nsty/ChrisBox/PCB/ChrisPCB.kicad_pcb

## KiCad design PCB/ChrisPCB.kicad_pcb (2026-08-30)

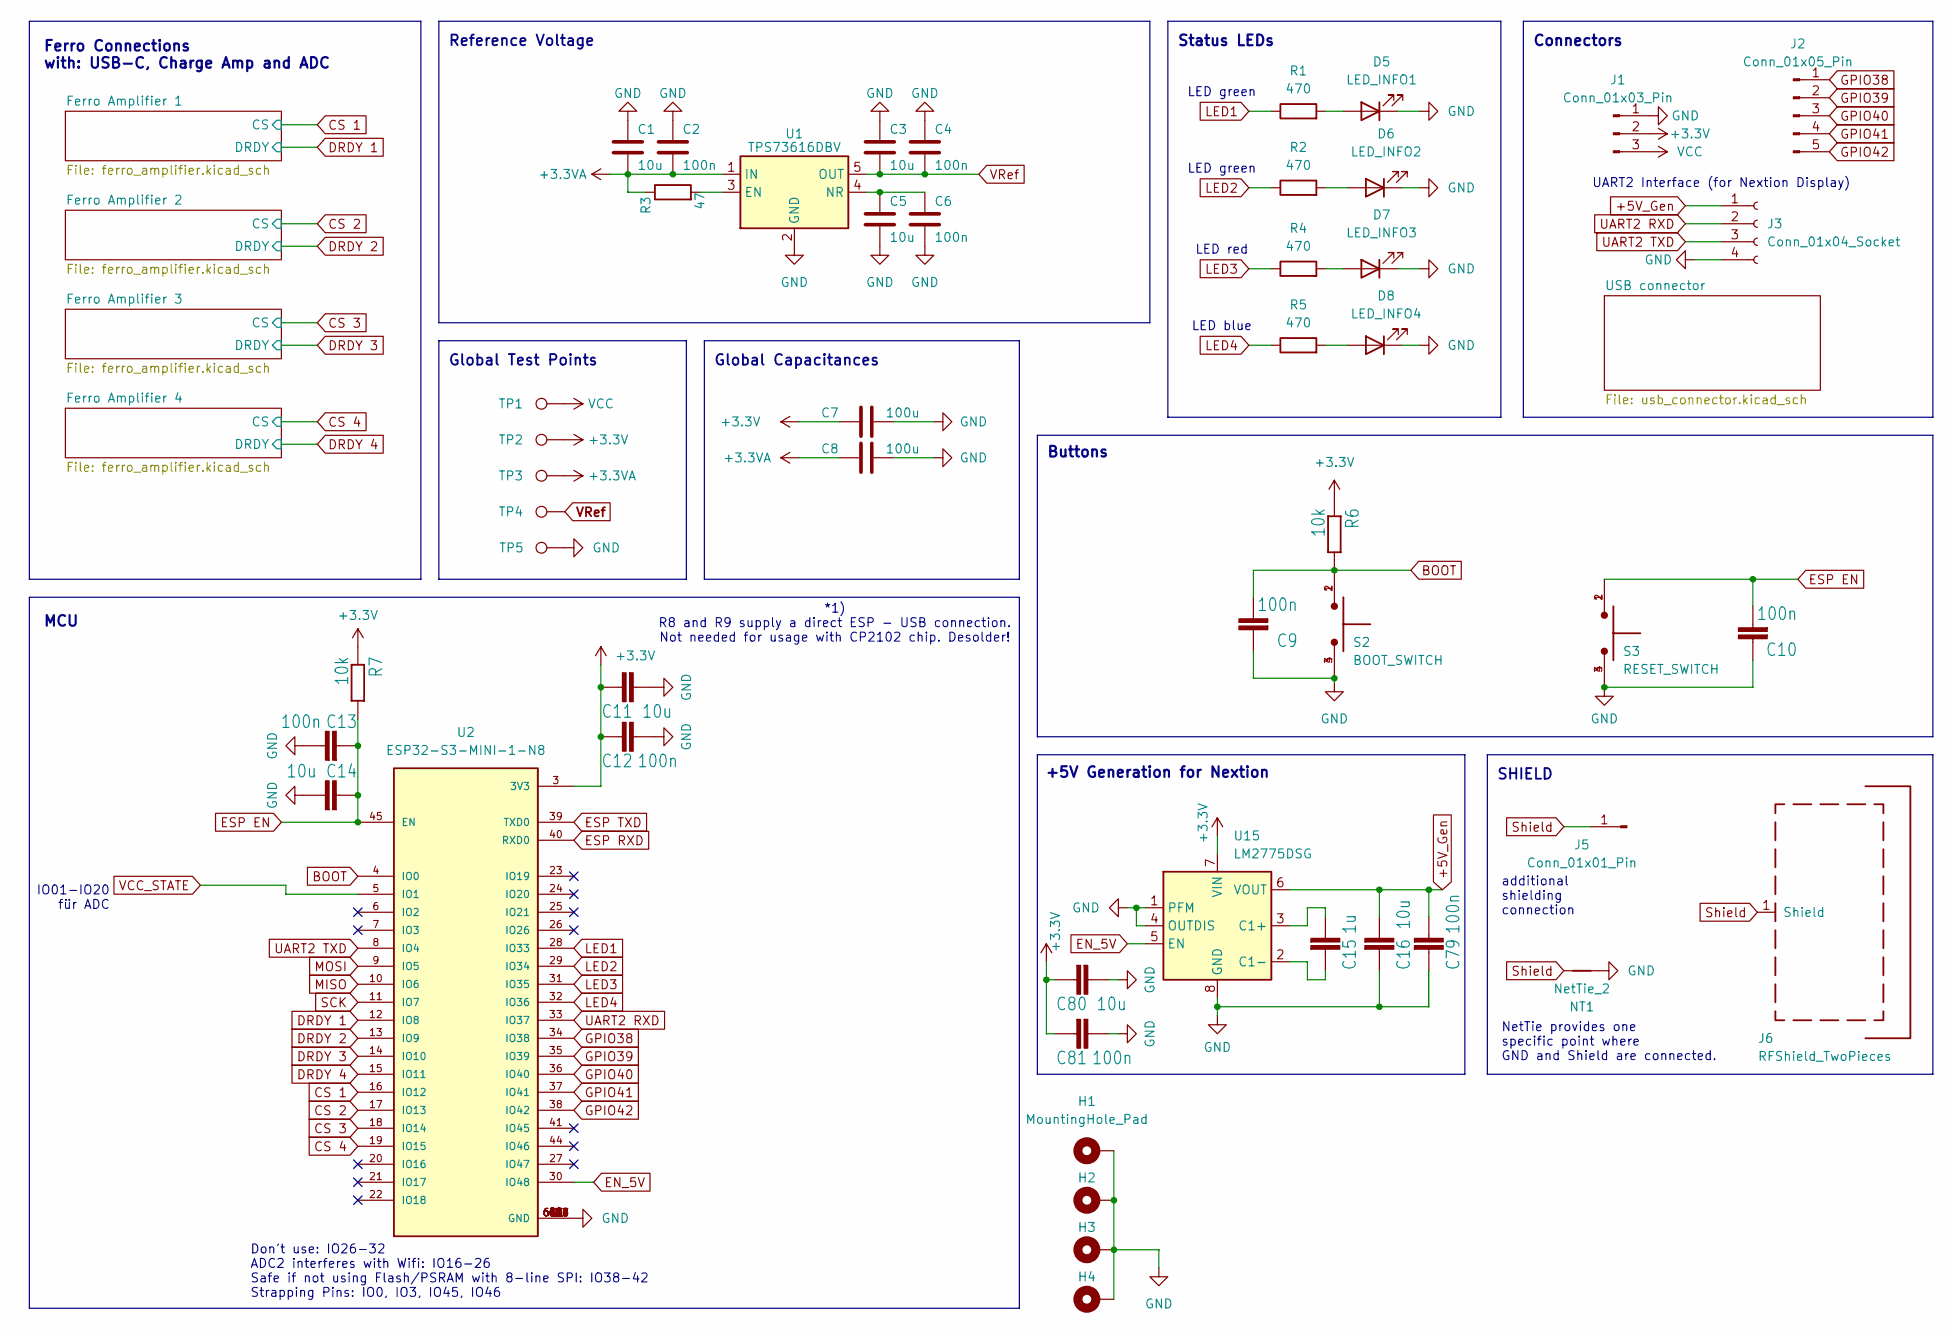
[picture p1: schematic ChrisPCB.kicad_sch, 4-Kanal Ferroelektret Platine]

Parts:
C1, C3, C5, C11, C14, C16, C80: 10u; C_0402_1005Metric
C2, C4, C6, C9, C10, C12, C13, C79, C81: 100n; C_0402_1005Metric
C7, C8: 100u; C_1206_3216Metric
C15: 1u; C_0402_1005Metric
D5: LED_INFO1; LED_0402_1005Metric
D6: LED_INFO2; LED_0402_1005Metric
D7: LED_INFO3; LED_0402_1005Metric
D8: LED_INFO4; LED_0402_1005Metric
H1, H2, H3, H4: MountingHole_Pad; MountingHole_3.2mm_M3_Pad
J1: Conn_01x03_Pin; PinHeader_1x03_P2.54mm_Vertical
J2: Conn_01x05_Pin; PinHeader_1x05_P2.54mm_Vertical
J3: Conn_01x04_Socket; JST_XH_B4B-XH-A_1x04_P2.50mm_Vertical
J5: Conn_01x01_Pin; PinHeader_1x01_P2.54mm_Vertical
J6: RFShield_TwoPieces; Laird_Technologies_BMI-S-205-F_38.10x25.40mm_HandSolder_Sel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
NT1: NetTie_2; NetTie-2_SMD_Pad0.5mm
R1, R2, R4, R5: 470; R_0402_1005Metric
R3: 47; R_0402_1005Metric
R6, R7: 10k; R_0402_1005Metric
S2: BOOT_SWITCH; SW_SKRPABE010
S3: RESET_SWITCH; SW_SKRPABE010
TP1, TP2, TP3, TP4, TP5: TestPoint; TestPoint_THTPad_D1.5mm_Drill0.7mm
U1: TPS73616DBV; SOT-23-5
U2: ESP32-S3-MINI-1-N8; XCVR_ESP32-S3-MINI-1-N8; PARTREV v0.6
U15: LM2775DSG; WSON-8-1EP_2x2mm_P0.5mm_EP0.9x1.6mm_ThermalVias

Connections:
+3.3V: C7.1, C11.2, C12.2, C80.2, C81.2, J1.2, R6.1, R7.1, TP2.1, U2.3 (3V3), U15.7 (VIN); also elsewhere on the board
+3.3VA: C1.2, C2.2, C8.1, R3.1, TP3.1, U1.1 (IN); also elsewhere on the board
+5V_Gen: C16.1, C79.1, J3.1, U15.6 (VOUT)
BOOT: C9.2, R6.2, S2.1, S2.2, U2.4 (IO0); also elsewhere on the board
CS 1: U2.16 (IO12); also elsewhere on the board
CS 2: U2.17 (IO13); also elsewhere on the board
CS 3: U2.18 (IO14); also elsewhere on the board
CS 4: U2.19 (IO15); also elsewhere on the board
DRDY 1: U2.12 (IO8); also elsewhere on the board
DRDY 2: U2.13 (IO9); also elsewhere on the board
DRDY 3: U2.14 (IO10); also elsewhere on the board
DRDY 4: U2.15 (IO11); also elsewhere on the board
EN_5V: U2.30 (IO48), U15.5 (EN)
ESP EN: C10.2, C13.2, C14.2, R7.2, S3.1, S3.2, U2.45 (EN); also elsewhere on the board
ESP RXD: U2.40 (RXD0); also elsewhere on the board
ESP TXD: U2.39 (TXD0); also elsewhere on the board
GND: C1.1, C2.1, C3.1, C4.1, C5.2, C6.2, C7.2, C8.2, C9.1, C10.1, C11.1, C12.1, C13.1, C14.1, C16.2, C79.2, C80.1, C81.1, D5.1 (K), D6.1 (K), D7.1 (K), D8.1 (K), H1.1, H2.1, H3.1, H4.1, J1.1, J3.4, NT1.1, S2.3, S2.4, S3.3, S3.4, TP5.1, U1.2 (GND), U2.1 (GND), U2.2 (GND), U2.42 (GND), U2.43 (GND), U2.46 (GND), U2.47 (GND), U2.48 (GND), U2.49 (GND), U2.50 (GND), U2.51 (GND), U2.52 (GND), U2.53 (GND), U2.54 (GND), U2.55 (GND), U2.56 (GND), U2.57 (GND), U2.58 (GND), U2.59 (GND), U2.60 (GND), U2.61 (GND), U2.61_1 (GND), U2.61_2 (GND), U2.61_3 (GND), U2.61_4 (GND), U2.61_5 (GND), U2.61_6 (GND), U2.61_7 (GND), U2.61_8 (GND), U2.62 (GND), U2.63 (GND), U2.64 (GND), U2.65 (GND), U15.1 (PFM), U15.4 (OUTDIS), U15.8 (GND), U15.9 (GND); also elsewhere on the board
GPIO38: J2.1, U2.34 (IO38)
GPIO39: J2.2, U2.35 (IO39)
GPIO40: J2.3, U2.36 (IO40)
GPIO41: J2.4, U2.37 (IO41)
GPIO42: J2.5, U2.38 (IO42)
LED1: R1.1, U2.28 (IO33)
LED2: R2.1, U2.29 (IO34)
LED3: R4.1, U2.31 (IO35)
LED4: R5.1, U2.32 (IO36)
MISO: U2.10 (IO6); also elsewhere on the board
MOSI: U2.9 (IO5); also elsewhere on the board
unnamed: D5.2 (A), R1.2
unnamed: D6.2 (A), R2.2
unnamed: D7.2 (A), R4.2
unnamed: D8.2 (A), R5.2
unnamed: R3.2, U1.3 (EN)
unnamed: C5.1, C6.1, U1.4 (NR)
unnamed: C15.1, U15.3 (C1+)
unnamed: C15.2, U15.2 (C1-)
SCK: U2.11 (IO7); also elsewhere on the board
Shield: J5.1, J6.1 (Shield), NT1.2; also elsewhere on the board
UART2 RXD: J3.2, U2.33 (IO37)
UART2 TXD: J3.3, U2.8 (IO4)
VCC: J1.3, TP1.1; also elsewhere on the board
VCC_STATE: U2.5 (IO1); also elsewhere on the board
VRef: C3.2, C4.2, TP4.1, U1.5 (OUT); also elsewhere on the board

Notes on the sheet:
+5V Generation for Nextion
Global Capacitances
Global Test Points
Buttons
LED green
Reference Voltage
Ferro Connections with: USB-C, Charge Amp and ADC
NetTie provides one specific point where GND and Shield are connected.
Status LEDs
IO01-IO20 für ADC
MCU
SHIELD
Don't use: IO26-32 ADC2 interferes with Wifi: IO16-26 Safe if not using Flash/PSRAM with 8-line SPI: IO38-42 Strapping Pins: IO0, IO3, IO45, IO46
additional shielding connection
LED blue
*1) R8 and R9 supply a direct ESP - USB connection. Not needed for usage with CP2102 chip. Desolder!
Connectors
LED red
UART2 Interface (for Nextion Display)

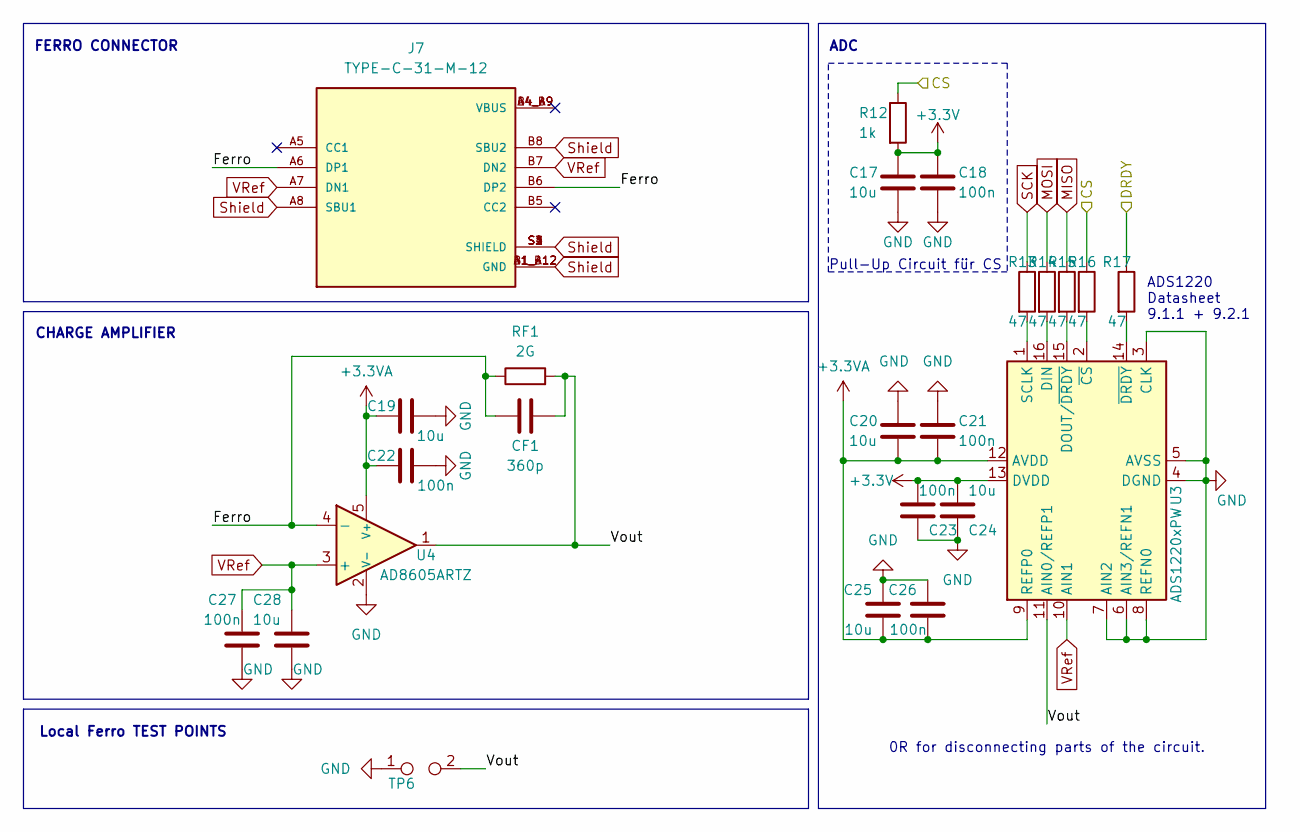
[picture p2: schematic ferro_amplifier.kicad_sch]

Parts:
C17, C19, C20, C24, C25, C28: 10u; C_0402_1005Metric
C18, C21, C22, C23, C26, C27: 100n; C_0402_1005Metric
CF1: 360p; C_0805_2012Metric
J7: TYPE-C-31-M-12; HRO_TYPE-C-31-M-12; PARTREV 2020.12.08
R12: 1k; R_0402_1005Metric
R13, R14, R15, R16, R17: 47; R_0402_1005Metric
RF1: 2G; R_0805_2012Metric
TP6: TestPoint_2Pole; TestPoint_2Pads_Pitch2.54mm_Drill0.8mm
U3: ADS1220xPW; TSSOP-16_4.4x5mm_P0.65mm
U4: AD8605ARTZ; SOT-23-5

Connections:
+3.3V: C17.1, C18.2, C23.2, C24.1, R12.2, U3.13 (DVDD); also elsewhere on the board
+3.3VA: C19.2, C20.2, C21.1, C22.1, C25.1, C26.2, U3.9 (REFP0), U3.12 (AVDD), U4.5 (V+); also elsewhere on the board
/Ferro Amplifier 1/Ferro: CF1.1, J7.A6 (DP1), J7.B6 (DP2), RF1.1, U4.4 (-)
/Ferro Amplifier 1/Vout: CF1.2, RF1.2, TP6.2, U3.11 (AIN0/REFP1), U4.1
CS 1: R12.1, R16.1; also elsewhere on the board
DRDY 1: R17.1; also elsewhere on the board
GND: C17.2, C18.1, C19.1, C20.1, C21.2, C22.2, C23.1, C24.2, C25.2, C26.1, C27.1, C28.2, TP6.1, U3.3 (CLK), U3.4 (DGND), U3.5 (AVSS), U3.6 (AIN3/REFN1), U3.7 (AIN2), U3.8 (REFN0), U4.2 (V-); also elsewhere on the board
MISO: R15.1; also elsewhere on the board
MOSI: R14.1; also elsewhere on the board
unnamed: R14.2, U3.16 (DIN)
unnamed: R15.2, U3.15 (DOUT/~DRDY)
unnamed: R13.2, U3.1 (SCLK)
unnamed: R16.2, U3.2 (~CS)
unnamed: R17.2, U3.14 (~DRDY)
SCK: R13.1; also elsewhere on the board
Shield: J7.A1_B12 (GND), J7.A8 (SBU1), J7.B1_A12 (GND), J7.B8 (SBU2), J7.S1 (SHIELD), J7.S2 (SHIELD), J7.S3 (SHIELD), J7.S4 (SHIELD); also elsewhere on the board
VRef: C27.2, C28.1, J7.A7 (DN1), J7.B7 (DN2), U3.10 (AIN1), U4.3 (+); also elsewhere on the board

Parts of its further copies:
C29, C31, C32, C36, C37, C40, C41, C43, C44, C48, C49, C52, C53, C55, C56, C60, C61, C64: 10u; C_0402_1005Metric
C30, C33, C34, C35, C38, C39, C42, C45, C46, C47, C50, C51, C54, C57, C58, C59, C62, C63: 100n; C_0402_1005Metric
CF2, CF3, CF4: 360p; C_0805_2012Metric
J8, J9, J10: TYPE-C-31-M-12; HRO_TYPE-C-31-M-12; PARTREV 2020.12.08
R18, R24, R30: 1k; R_0402_1005Metric
R19, R20, R21, R22, R23, R25, R26, R27, R28, R29, R31, R32, R33, R34, R35: 47; R_0402_1005Metric
RF2, RF3, RF4: 2G; R_0805_2012Metric
TP7, TP8, TP9: TestPoint_2Pole; TestPoint_2Pads_Pitch2.54mm_Drill0.8mm
U5, U7, U9: ADS1220xPW; TSSOP-16_4.4x5mm_P0.65mm
U6, U8, U10: AD8605ARTZ; SOT-23-5

Connections of its further copies:
+3.3V: C29.1, C30.2, C35.2, C36.1, C41.1, C42.2, C47.2, C48.1, C53.1, C54.2, C59.2, C60.1, R18.2, R24.2, R30.2, U5.13 (DVDD), U7.13 (DVDD), U9.13 (DVDD); also elsewhere on the board
+3.3VA: C31.2, C32.2, C33.1, C34.1, C37.1, C38.2, C43.2, C44.2, C45.1, C46.1, C49.1, C50.2, C55.2, C56.2, C57.1, C58.1, C61.1, C62.2, U5.9 (REFP0), U5.12 (AVDD), U6.5 (V+), U7.9 (REFP0), U7.12 (AVDD), U8.5 (V+), U9.9 (REFP0), U9.12 (AVDD), U10.5 (V+); also elsewhere on the board
/Ferro Amplifier 2/Ferro: CF2.1, J8.A6 (DP1), J8.B6 (DP2), RF2.1, U6.4 (-)
/Ferro Amplifier 2/Vout: CF2.2, RF2.2, TP7.2, U5.11 (AIN0/REFP1), U6.1
/Ferro Amplifier 3/Ferro: CF3.1, J9.A6 (DP1), J9.B6 (DP2), RF3.1, U8.4 (-)
/Ferro Amplifier 3/Vout: CF3.2, RF3.2, TP8.2, U7.11 (AIN0/REFP1), U8.1
/Ferro Amplifier 4/Ferro: CF4.1, J10.A6 (DP1), J10.B6 (DP2), RF4.1, U10.4 (-)
/Ferro Amplifier 4/Vout: CF4.2, RF4.2, TP9.2, U9.11 (AIN0/REFP1), U10.1
CS 2: R18.1, R22.1; also elsewhere on the board
CS 3: R24.1, R28.1; also elsewhere on the board
CS 4: R30.1, R34.1; also elsewhere on the board
DRDY 2: R23.1; also elsewhere on the board
DRDY 3: R29.1; also elsewhere on the board
DRDY 4: R35.1; also elsewhere on the board
GND: C29.2, C30.1, C31.1, C32.1, C33.2, C34.2, C35.1, C36.2, C37.2, C38.1, C39.1, C40.2, C41.2, C42.1, C43.1, C44.1, C45.2, C46.2, C47.1, C48.2, C49.2, C50.1, C51.1, C52.2, C53.2, C54.1, C55.1, C56.1, C57.2, C58.2, C59.1, C60.2, C61.2, C62.1, C63.1, C64.2, TP7.1, TP8.1, TP9.1, U5.3 (CLK), U5.4 (DGND), U5.5 (AVSS), U5.6 (AIN3/REFN1), U5.7 (AIN2), U5.8 (REFN0), U6.2 (V-), U7.3 (CLK), U7.4 (DGND), U7.5 (AVSS), U7.6 (AIN3/REFN1), U7.7 (AIN2), U7.8 (REFN0), U8.2 (V-), U9.3 (CLK), U9.4 (DGND), U9.5 (AVSS), U9.6 (AIN3/REFN1), U9.7 (AIN2), U9.8 (REFN0), U10.2 (V-); also elsewhere on the board
MISO: R21.1, R27.1, R33.1; also elsewhere on the board
MOSI: R20.1, R26.1, R32.1; also elsewhere on the board
unnamed: R20.2, U5.16 (DIN)
unnamed: R21.2, U5.15 (DOUT/~DRDY)
unnamed: R19.2, U5.1 (SCLK)
unnamed: R22.2, U5.2 (~CS)
unnamed: R23.2, U5.14 (~DRDY)
unnamed: R26.2, U7.16 (DIN)
unnamed: R27.2, U7.15 (DOUT/~DRDY)
unnamed: R25.2, U7.1 (SCLK)
unnamed: R28.2, U7.2 (~CS)
unnamed: R29.2, U7.14 (~DRDY)
unnamed: R32.2, U9.16 (DIN)
unnamed: R33.2, U9.15 (DOUT/~DRDY)
unnamed: R31.2, U9.1 (SCLK)
unnamed: R34.2, U9.2 (~CS)
unnamed: R35.2, U9.14 (~DRDY)
SCK: R19.1, R25.1, R31.1; also elsewhere on the board
Shield: J8.A1_B12 (GND), J8.A8 (SBU1), J8.B1_A12 (GND), J8.B8 (SBU2), J8.S1 (SHIELD), J8.S2 (SHIELD), J8.S3 (SHIELD), J8.S4 (SHIELD), J9.A1_B12 (GND), J9.A8 (SBU1), J9.B1_A12 (GND), J9.B8 (SBU2), J9.S1 (SHIELD), J9.S2 (SHIELD), J9.S3 (SHIELD), J9.S4 (SHIELD), J10.A1_B12 (GND), J10.A8 (SBU1), J10.B1_A12 (GND), J10.B8 (SBU2), J10.S1 (SHIELD), J10.S2 (SHIELD), J10.S3 (SHIELD), J10.S4 (SHIELD); also elsewhere on the board
VRef: C39.2, C40.1, C51.2, C52.1, C63.2, C64.1, J8.A7 (DN1), J8.B7 (DN2), J9.A7 (DN1), J9.B7 (DN2), J10.A7 (DN1), J10.B7 (DN2), U5.10 (AIN1), U6.3 (+), U7.10 (AIN1), U8.3 (+), U9.10 (AIN1), U10.3 (+); also elsewhere on the board

Notes on the sheet:
0R for disconnecting parts of the circuit.
Pull-Up Circuit für CS
CHARGE AMPLIFIER
ADS1220 Datasheet 9.1.1 + 9.2.1
ADC
Local Ferro TEST POINTS
FERRO CONNECTOR

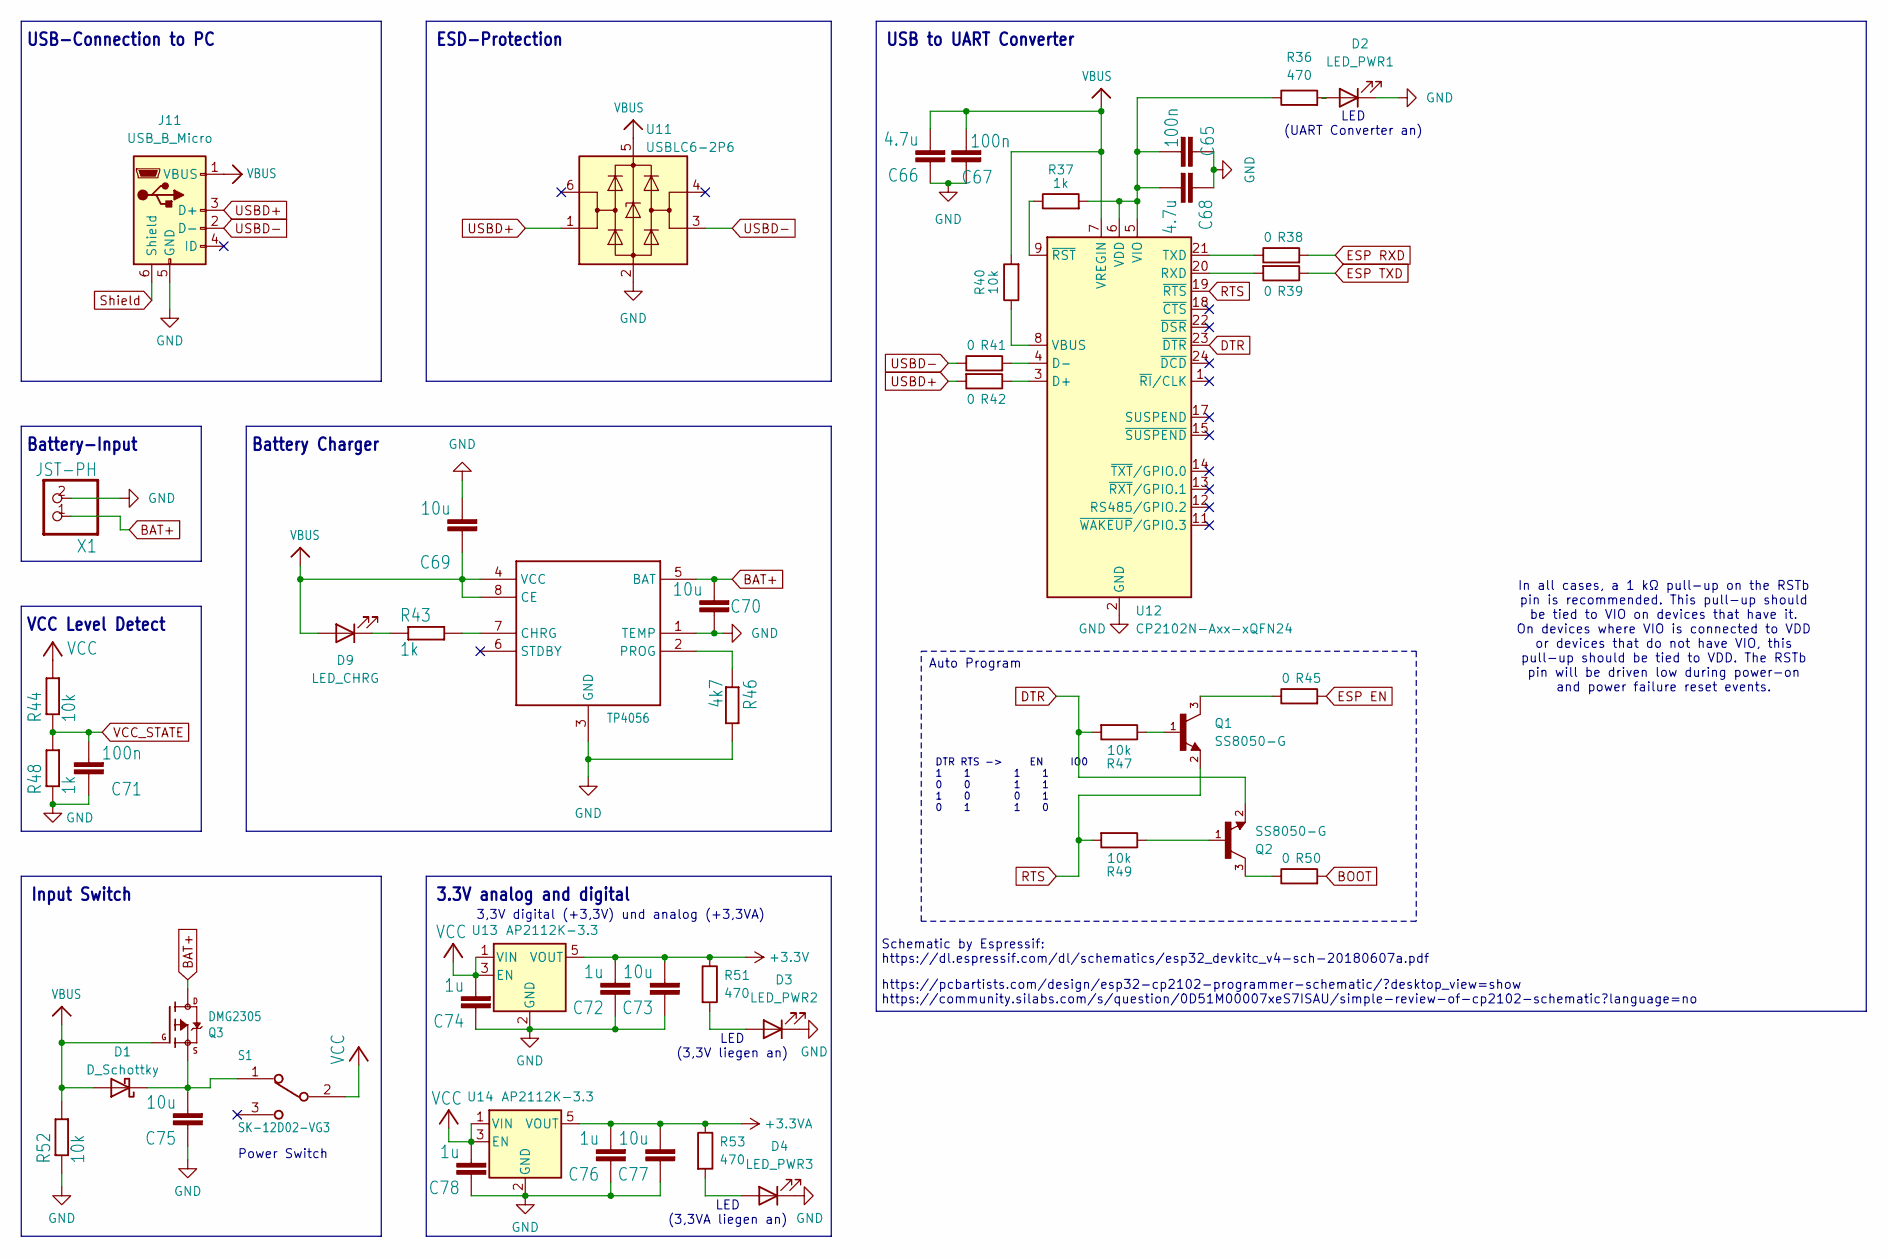
[picture p3: schematic usb_connector.kicad_sch]

Parts:
C65, C67, C71: 100n; C_0402_1005Metric
C66, C68: 4.7u; C_0402_1005Metric
C69, C70, C73, C75, C77: 10u; C_0402_1005Metric
C72, C74, C76, C78: 1u; C_0402_1005Metric
D1: D_Schottky; D_SMA
D2: LED_PWR1; LED_0402_1005Metric
D3: LED_PWR2; LED_0402_1005Metric
D4: LED_PWR3; LED_0402_1005Metric
D9: LED_CHRG; LED_0402_1005Metric
IC1: TP4056; SOP-8
J11: USB_B_Micro; USB_Micro-B_Molex-105017-0001
Q1, Q2: SS8050-G; TRANS_SS8050-G; PARTREV A
Q3: DMG2305; SOT-23
R36, R51, R53: 470; R_0402_1005Metric
R37, R43, R48: 1k; R_0402_1005Metric
R38, R39, R41, R42, R45, R50: 0; R_0402_1005Metric_Pad0.72x0.64mm_HandSolder
R40, R44, R47, R49, R52: 10k; R_0402_1005Metric
R46: 4k7; R_0402_1005Metric
S1: SK-12D02-VG3; SK12D02VG3
U11: USBLC6-2P6; SOT-666
U12: CP2102N-Axx-xQFN24; QFN-24-1EP_4x4mm_P0.5mm_EP2.6x2.6mm
U13, U14: AP2112K-3.3; SOT-23-5
X1: JST-PH; JST_PH_B2B-PH-K_1x02_P2.00mm_Vertical

Connections:
+3.3V: C72.2, C73.2, R51.1, U13.5 (VOUT); also elsewhere on the board
+3.3VA: C76.2, C77.2, R53.1, U14.5 (VOUT); also elsewhere on the board
BAT+: C70.2, IC1.5 (BAT), Q3.3 (D), X1.1
BOOT: R50.2; also elsewhere on the board
DTR: Q2.2, R47.2, U12.23 (~DTR)
ESP EN: R45.2; also elsewhere on the board
ESP RXD: R38.2; also elsewhere on the board
ESP TXD: R39.1; also elsewhere on the board
GND: C65.1, C66.1, C67.1, C68.1, C69.2, C70.1, C71.1, C72.1, C73.1, C74.1, C75.1, C76.1, C77.1, C78.1, D2.1 (K), D3.1 (K), D4.1 (K), IC1.1 (TEMP), IC1.3 (GND), J11.5 (GND), R46.2, R48.1, R52.1, U11.2 (GND), U12.2 (GND), U12.25 (GND), U13.2 (GND), U14.2 (GND), X1.2; also elsewhere on the board
unnamed: C75.2, D1.1 (K), Q3.2 (S), S1.1
unnamed: D2.2 (A), R36.2
unnamed: D3.2 (A), R51.2
unnamed: D4.2 (A), R53.2
unnamed: D9.1 (K), R43.1
unnamed: IC1.7 (CHRG), R43.2
unnamed: IC1.2 (PROG), R46.1
unnamed: Q1.1, R47.1
unnamed: Q1.3, R45.1
unnamed: Q2.1, R49.1
unnamed: Q2.3, R50.1
unnamed: R42.1, U12.3 (D+)
unnamed: R41.2, U12.4 (D-)
unnamed: R39.2, U12.20 (RXD)
unnamed: R38.1, U12.21 (TXD)
unnamed: R40.1, U12.8 (VBUS)
unnamed: C65.2, C68.2, R36.1, R37.2, U12.5 (VIO), U12.6 (VDD)
unnamed: R37.1, U12.9 (~RST)
RTS: Q1.2, R49.2, U12.19 (~RTS)
Shield: J11.6 (Shield); also elsewhere on the board
USBD+: J11.3 (D+), R42.2, U11.1 (I/O1)
USBD-: J11.2 (D-), R41.1, U11.3 (I/O2)
VBUS: C66.2, C67.2, C69.1, D1.2 (A), D9.2 (A), IC1.4 (VCC), IC1.8 (CE), J11.1 (VBUS), Q3.1 (G), R40.2, R52.2, U11.5 (VBUS), U12.7 (VREGIN)
VCC: C74.2, C78.2, R44.2, S1.2, U13.1 (VIN), U13.3 (EN), U14.1 (VIN), U14.3 (EN); also elsewhere on the board
VCC_STATE: C71.2, R44.1, R48.2; also elsewhere on the board

Notes on the sheet:
LED (UART Converter an)
Battery Charger
USB-Connection to PC
Auto Program
VCC Level Detect
LED (3,3V liegen an)
3,3V digital (+3,3V) und analog (+3,3VA)
Power Switch
In all cases, a 1 kΩ pull-up on the RSTb pin is recommended. This pull-up should be tied to VIO on devices that have it. On devices where VIO is connected to VDD or devices that do not have VIO, this pull-up should be tied to VDD. The RSTb pin will be driven low during power-on and power failure re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
USB to UART Converter
3.3V analog and digital
DTR RTS -> EN IO0 1 1 1 1 0 0 1 1 1 0 0 1 0 1 1 0
Battery-Input
ESD-Protection
LED (3,3VA liegen an)
Input Switch
Schematic by Espressif: https://dl.espressif.com/dl/schematics/esp32_devkitc_v4-sch-20180607a.pdf
https://pcbartists.com/design/esp32-cp2102-programmer-schematic/?desktop_view=show https://community.silabs.com/s/question/0D51M00007xeS7ISAU/simple-review-of-cp2102-schematic?language=no

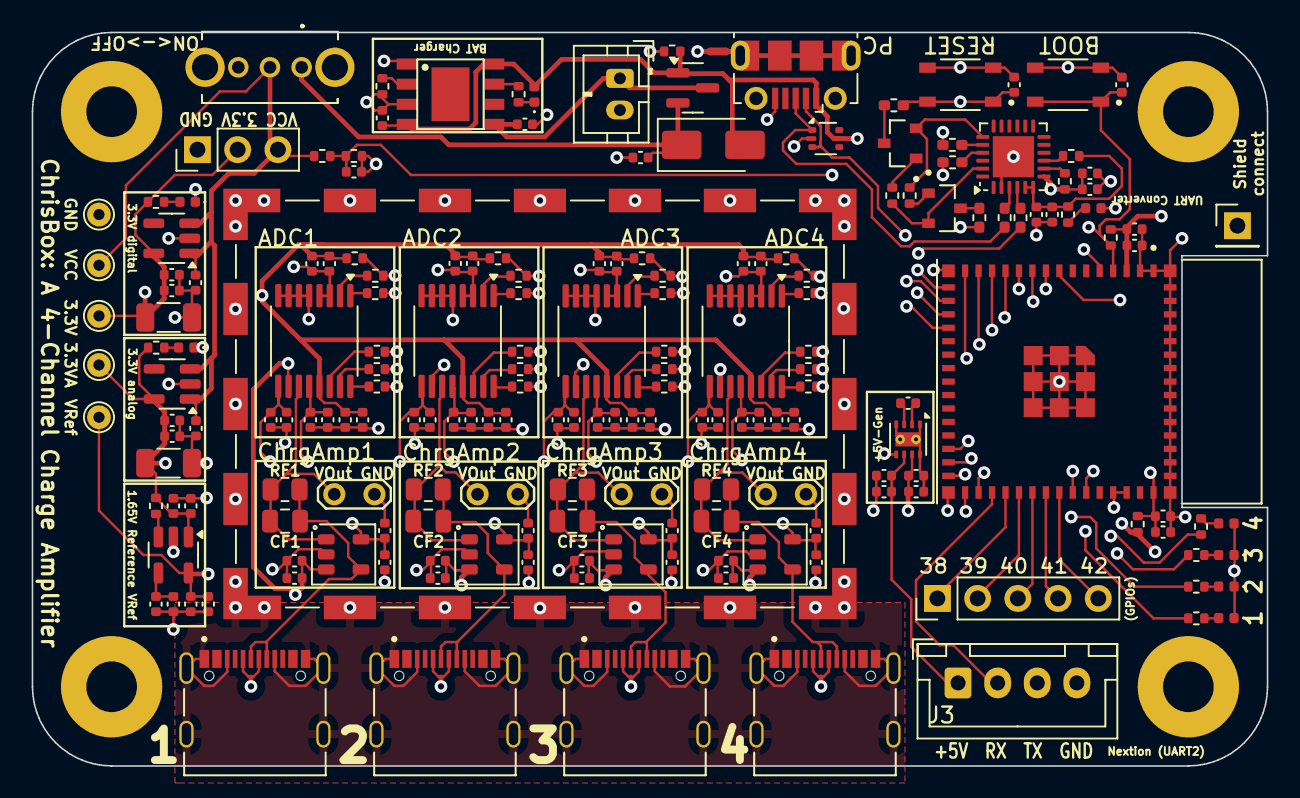
[picture p4: board ChrisPCB.kicad_pcb from above]

Board: 4 copper layers, 78.0 x 46.3 mm, 194 parts (0 on the bottom side), 95 nets.
